Samub432/acoustic-sensor/python/trials/03_baseline_new_hardware/baseline1.csv

pc_timestamp | freq_hz | ampl_adc | arduino_ms | mode | raw_line
1784644223.483011 | 0 | 0 | 0 | META | # BIOREATTORE ACUSTICO v1.0
1784644223.483011 | 0 | 0 | 0 | META | # freq_hz,ampl_adc,timestamp_ms,mode
1784644223.483011 | 0 | 0 | 0 | META | # READY
1784644223.483011 | 0 | 0 | 0 | META | # MODE:SWEEP
1784644223.483011 | 0 | 0 | 0 | META | # SWEEP_START,376
1784644223.5705004 | 999 | 56 | 460 | S | 999,56,460,S
1784644223.6527245 | 1021 | 44 | 544 | S | 1021,44,544,S
1784644223.7385697 | 1042 | 34 | 628 | S | 1042,34,628,S
1784644223.8189645 | 1064 | 25 | 712 | S | 1064,25,712,S
1784644223.900641 | 1087 | 16 | 795 | S | 1087,16,795,S
1784644223.9816594 | 1110 | 15 | 879 | S | 1110,15,879,S
1784644224.062832 | 1133 | 15 | 963 | S | 1133,15,963,S
1784644224.1446793 | 1157 | 15 | 1046 | S | 1157,15,1046,S
1784644224.2422915 | 1181 | 11 | 1130 | S | 1181,11,1130,S
1784644224.3192635 | 1206 | 10 | 1214 | S | 1206,10,1214,S
1784644224.4042242 | 1232 | 17 | 1297 | S | 1232,17,1297,S
1784644224.4849968 | 1258 | 11 | 1380 | S | 1258,11,1380,S
1784644224.5657492 | 1284 | 23 | 1464 | S | 1284,23,1464,S
1784644224.646768 | 1311 | 34 | 1547 | S | 1311,34,1547,S
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
