Samub432/acoustic-sensor/python/trials/03_baseline_new_hardware/baseline2.csv

pc_timestamp | freq_hz | ampl_adc | arduino_ms | mode | raw_line
1784646427.5064514 | 0 | 0 | 0 | META | # BIOREATTORE ACUSTICO v1.0
1784646427.5064514 | 0 | 0 | 0 | META | # freq_hz,ampl_adc,timestamp_ms,mode
1784646427.5064514 | 0 | 0 | 0 | META | # READY
1784646427.5064514 | 0 | 0 | 0 | META | # MODE:SWEEP
1784646427.5064514 | 0 | 0 | 0 | META | # SWEEP_START,377
1784646427.594136 | 999 | 70 | 461 | S | 999,70,461,S
1784646427.6787186 | 1021 | 51 | 545 | S | 1021,51,545,S
1784646427.7622252 | 1042 | 39 | 629 | S | 1042,39,629,S
1784646427.844145 | 1064 | 29 | 713 | S | 1064,29,713,S
1784646427.9252758 | 1087 | 23 | 797 | S | 1087,23,797,S
1784646428.0065086 | 1110 | 21 | 881 | S | 1110,21,881,S
1784646428.0872135 | 1133 | 16 | 964 | S | 1133,16,964,S
1784646428.1713135 | 1157 | 14 | 1048 | S | 1157,14,1048,S
1784646428.2657914 | 1181 | 10 | 1131 | S | 1181,10,1131,S
1784646428.3448424 | 1206 | 11 | 1215 | S | 1206,11,1215,S
1784646428.4296103 | 1232 | 19 | 1298 | S | 1232,19,1298,S
1784646428.5119517 | 1258 | 13 | 1382 | S | 1258,13,1382,S
1784646428.5937316 | 1284 | 9 | 1465 | S | 1284,9,1465,S
1784646428.6794894 | 1311 | 15 | 1548 | S | 1311,15,1548,S
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
