Samub432/acoustic-sensor/python/trials/03_baseline_new_hardware/baseline3.csv

pc_timestamp | freq_hz | ampl_adc | arduino_ms | mode | raw_line
1784647524.6125307 | 0 | 0 | 0 | META | # BIOREATTORE ACUSTICO v1.0
1784647524.6125307 | 0 | 0 | 0 | META | # freq_hz,ampl_adc,timestamp_ms,mode
1784647524.6125307 | 0 | 0 | 0 | META | # READY
1784647524.6125307 | 0 | 0 | 0 | META | # MODE:SWEEP
1784647524.6125307 | 0 | 0 | 0 | META | # SWEEP_START,378
1784647524.6897862 | 999 | 60 | 461 | S | 999,60,461,S
1784647524.7707486 | 1021 | 48 | 545 | S | 1021,48,545,S
1784647524.8682554 | 1042 | 34 | 629 | S | 1042,34,629,S
1784647524.9514194 | 1064 | 28 | 713 | S | 1064,28,713,S
1784647525.0297976 | 1087 | 20 | 797 | S | 1087,20,797,S
1784647525.1105657 | 1110 | 19 | 881 | S | 1110,19,881,S
1784647525.1944249 | 1133 | 14 | 964 | S | 1133,14,964,S
1784647525.272624 | 1157 | 12 | 1048 | S | 1157,12,1048,S
1784647525.3698897 | 1181 | 10 | 1131 | S | 1181,10,1131,S
1784647525.4511354 | 1206 | 13 | 1215 | S | 1206,13,1215,S
1784647525.5229735 | 1232 | 16 | 1298 | S | 1232,16,1298,S
1784647525.6175044 | 1258 | 11 | 1382 | S | 1258,11,1382,S
1784647525.7014065 | 1284 | 21 | 1465 | S | 1284,21,1465,S
1784647525.7872736 | 1311 | 18 | 1549 | S | 1311,18,1549,S
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
