Samub432/acoustic-sensor/holder/Acoustic Sensor - Holder.png

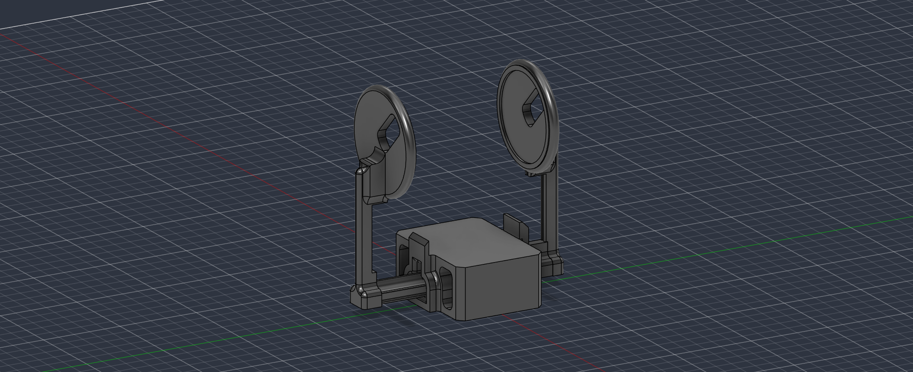
holder/Acoustic Sensor - Holder.png
