Samub432/acoustic-sensor/holder/Acoustic Sensor - Holder.stl

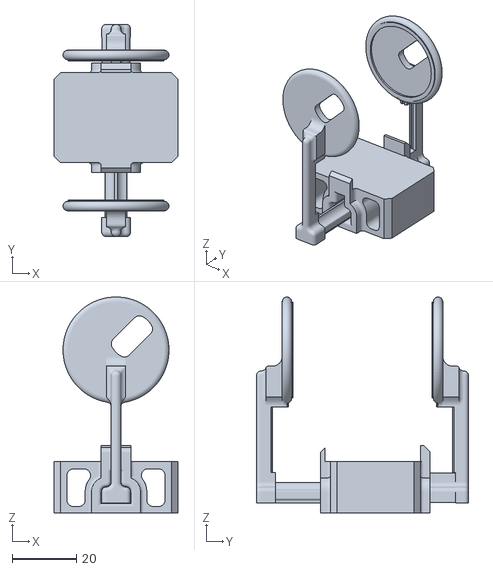
[picture p2: CAD file, 2026-10-16]
holder/Acoustic Sensor - Holder.stl
38.5 x 66.0 x 67.2
