Samub432/acoustic-sensor/(list of files, cad)

Other CAD files:
holder/Acoustic Sensor - Holder.f3d
