Samub432/acoustic-sensor/python/trials/10_Experiment_Nostoc_10052026/Blank 5-10-2026/blank_dark.csv

pc_timestamp | freq_hz | ampl_adc | arduino_ms | mode | raw_line
1791193425.825013 | 0 | 0 | 0 | META | # BIOREATTORE ACUSTICO v1.0
1791193425.825941 | 0 | 0 | 0 | META | # freq_hz,ampl_adc,timestamp_ms,mode
1791193425.826184 | 0 | 0 | 0 | META | # READY
1791193425.826538 | 0 | 0 | 0 | META | # MODE:SWEEP
1791193425.8270059 | 0 | 0 | 0 | META | # SWEEP_START,384
1791193425.827355 | 999 | 81 | 467 | S | 999,81,467,S
1791193425.8277388 | 1021 | 67 | 550 | S | 1021,67,550,S
1791193425.8281002 | 1042 | 63 | 634 | S | 1042,63,634,S
1791193425.828448 | 1064 | 63 | 718 | S | 1064,63,718,S
1791193425.88098 | 1087 | 66 | 802 | S | 1087,66,802,S
1791193425.963468 | 1110 | 58 | 886 | S | 1110,58,886,S
1791193426.0451488 | 1133 | 54 | 969 | S | 1133,54,969,S
1791193426.1312141 | 1157 | 59 | 1053 | S | 1157,59,1053,S
1791193426.2134058 | 1181 | 45 | 1136 | S | 1181,45,1136,S
1791193426.298846 | 1206 | 44 | 1220 | S | 1206,44,1220,S
1791193426.381312 | 1232 | 59 | 1303 | S | 1232,59,1303,S
1791193426.463234 | 1258 | 39 | 1387 | S | 1258,39,1387,S
1791193426.548935 | 1284 | 36 | 1470 | S | 1284,36,1470,S
1791193426.6311722 | 1311 | 20 | 1554 | S | 1311,20,1554,S
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
