Samub432/acoustic-sensor/python/trials/10_Experiment_Nostoc_10052026/Blank 5-10-2026/blank_light.csv

pc_timestamp | freq_hz | ampl_adc | arduino_ms | mode | raw_line
1791194553.3010108 | 0 | 0 | 0 | META | # BIOREATTORE ACUSTICO v1.0
1791194553.301952 | 0 | 0 | 0 | META | # freq_hz,ampl_adc,timestamp_ms,mode
1791194553.302198 | 0 | 0 | 0 | META | # READY
1791194553.3025541 | 0 | 0 | 0 | META | # MODE:SWEEP
1791194553.303026 | 0 | 0 | 0 | META | # SWEEP_START,380
1791194553.362933 | 999 | 84 | 464 | S | 999,84,464,S
1791194553.448599 | 1021 | 79 | 547 | S | 1021,79,547,S
1791194553.531007 | 1042 | 55 | 631 | S | 1042,55,631,S
1791194553.616269 | 1064 | 51 | 715 | S | 1064,51,715,S
1791194553.698892 | 1087 | 46 | 799 | S | 1087,46,799,S
1791194553.780649 | 1110 | 60 | 883 | S | 1110,60,883,S
1791194553.866636 | 1133 | 42 | 966 | S | 1133,42,966,S
1791194553.948766 | 1157 | 38 | 1050 | S | 1157,38,1050,S
1791194554.034396 | 1181 | 51 | 1133 | S | 1181,51,1133,S
1791194554.11669 | 1206 | 42 | 1217 | S | 1206,42,1217,S
1791194554.19859 | 1232 | 44 | 1300 | S | 1232,44,1300,S
1791194554.28439 | 1258 | 35 | 1384 | S | 1258,35,1384,S
1791194554.3665621 | 1284 | 31 | 1467 | S | 1284,31,1467,S
1791194554.448451 | 1311 | 29 | 1551 | S | 1311,29,1551,S
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
