Samub432/acoustic-sensor/python/trials/09_Experiment_Nostoc_09232026/BLANK_23.9.26/blank_001.csv

pc_timestamp | freq_hz | ampl_adc | arduino_ms | mode | raw_line
1790155661.404864 | 0 | 0 | 0 | META | # BIOREATTORE ACUSTICO v1.0
1790155661.405893 | 0 | 0 | 0 | META | # freq_hz,ampl_adc,timestamp_ms,mode
1790155661.4061491 | 0 | 0 | 0 | META | # READY
1790155661.408567 | 0 | 0 | 0 | META | # MODE:SWEEP
1790155661.4091752 | 0 | 0 | 0 | META | # SWEEP_START,385
1790155661.490792 | 999 | 72 | 468 | S | 999,72,468,S
1790155661.576233 | 1021 | 62 | 552 | S | 1021,62,552,S
1790155661.6586292 | 1042 | 59 | 636 | S | 1042,59,636,S
1790155661.740525 | 1064 | 64 | 720 | S | 1064,64,720,S
1790155661.8265479 | 1087 | 58 | 803 | S | 1087,58,803,S
1790155661.9085839 | 1110 | 65 | 887 | S | 1110,65,887,S
1790155661.9944808 | 1133 | 81 | 971 | S | 1133,81,971,S
1790155662.0765781 | 1157 | 84 | 1054 | S | 1157,84,1054,S
1790155662.1619468 | 1181 | 74 | 1138 | S | 1181,74,1138,S
1790155662.244549 | 1206 | 63 | 1222 | S | 1206,63,1222,S
1790155662.326443 | 1232 | 55 | 1305 | S | 1232,55,1305,S
1790155662.412145 | 1258 | 47 | 1388 | S | 1258,47,1388,S
1790155662.494288 | 1284 | 46 | 1472 | S | 1284,46,1472,S
1790155662.576309 | 1311 | 39 | 1555 | S | 1311,39,1555,S
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
