Samub432/acoustic-sensor/python/trials/09_Experiment_Nostoc_09232026/BLANK_23.9.26/blank_002.csv

pc_timestamp | freq_hz | ampl_adc | arduino_ms | mode | raw_line
1790156561.514333 | 0 | 509 | 900654 | P | 0,509,900654,P
1790156561.6167831 | 0 | 504 | 900754 | P | 0,504,900754,P
1790156561.715209 | 0 | 508 | 900854 | P | 0,508,900854,P
1790156561.817483 | 0 | 510 | 900956 | P | 0,510,900956,P
1790156561.915808 | 0 | 513 | 901056 | P | 0,513,901056,P
1790156562.018212 | 0 | 510 | 901156 | P | 0,510,901156,P
1790156562.120091 | 0 | 515 | 901257 | P | 0,515,901257,P
1790156562.218935 | 0 | 504 | 901357 | P | 0,504,901357,P
1790156562.321066 | 0 | 496 | 901458 | P | 0,496,901458,P
1790156562.4196491 | 0 | 503 | 901559 | P | 0,503,901559,P
1790156562.521834 | 0 | 503 | 901659 | P | 0,503,901659,P
1790156562.620394 | 0 | 496 | 901760 | P | 0,496,901760,P
1790156562.7224262 | 0 | 499 | 901861 | P | 0,499,901861,P
1790156562.8210251 | 0 | 496 | 901961 | P | 0,496,901961,P
1790156562.9234529 | 0 | 519 | 902062 | P | 0,519,902062,P
1790156563.0251598 | 0 | 0 | 0 | META | # SWEEP_START,902162
1790156563.107353 | 999 | 152 | 902246 | S | 999,152,902246,S
1790156563.193065 | 1021 | 102 | 902330 | S | 1021,102,902330,S
1790156563.275885 | 1042 | 131 | 902414 | S | 1042,131,902414,S
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
