Samub432/acoustic-sensor/python/trials/09_Experiment_Nostoc_09232026/BLANK_23.9.26/blank_003.csv

pc_timestamp | freq_hz | ampl_adc | arduino_ms | mode | raw_line
1790158285.9810529 | 2305 | 27 | 1657485 | S | 2305,27,1657485,S
1790158285.981953 | 2353 | 22 | 1657568 | S | 2353,22,1657568,S
1790158285.982672 | 2403 | 20 | 1657651 | S | 2403,20,1657651,S
1790158285.983168 | 2454 | 32 | 1657733 | S | 2454,32,1657733,S
1790158285.9836001 | 0 | 513 | 2622540 | P | 0,513,2622540,P
1790158285.9840288 | 0 | 510 | 2622641 | P | 0,510,2622641,P
1790158285.984437 | 0 | 525 | 2622742 | P | 0,525,2622742,P
1790158285.9848452 | 0 | 507 | 2622842 | P | 0,507,2622842,P
1790158285.9852521 | 0 | 511 | 2622943 | P | 0,511,2622943,P
1790158285.9856598 | 0 | 512 | 2623043 | P | 0,512,2623043,P
1790158286.196964 | 0 | 510 | 2623144 | P | 0,510,2623144,P
1790158286.197412 | 0 | 516 | 2623245 | P | 0,516,2623245,P
1790158286.197837 | 0 | 508 | 2623345 | P | 0,508,2623345,P
1790158286.198262 | 0 | 515 | 2623446 | P | 0,515,2623446,P
1790158286.198685 | 0 | 512 | 2623547 | P | 0,512,2623547,P
1790158286.1991072 | 0 | 524 | 2623647 | P | 0,524,2623647,P
1790158286.19953 | 0 | 551 | 2623748 | P | 0,551,2623748,P
1790158286.199952 | 0 | 460 | 2623848 | P | 0,460,2623848,P
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
