Samub432/acoustic-sensor/python/trials/09_Experiment_Nostoc_09232026/BLANK_23.9.26/warmup_blank1.csv

pc_timestamp | freq_hz | ampl_adc | arduino_ms | mode | raw_line
1790154015.994741 | 0 | 0 | 0 | META | # BIOREATTORE ACUSTICO v1.0
1790154015.995727 | 0 | 0 | 0 | META | # freq_hz,ampl_adc,timestamp_ms,mode
1790154015.9959722 | 0 | 0 | 0 | META | # READY
1790154015.996332 | 0 | 0 | 0 | META | # MODE:SWEEP
1790154015.996804 | 0 | 0 | 0 | META | # SWEEP_START,380
1790154016.0316448 | 999 | 88 | 464 | S | 999,88,464,S
1790154016.1180701 | 1021 | 62 | 548 | S | 1021,62,548,S
1790154016.19999 | 1042 | 62 | 631 | S | 1042,62,631,S
1790154016.2860339 | 1064 | 61 | 715 | S | 1064,61,715,S
1790154016.367638 | 1087 | 74 | 799 | S | 1087,74,799,S
1790154016.453394 | 1110 | 86 | 883 | S | 1110,86,883,S
1790154016.53596 | 1133 | 80 | 966 | S | 1133,80,966,S
1790154016.621292 | 1157 | 87 | 1050 | S | 1157,87,1050,S
1790154016.70381 | 1181 | 60 | 1134 | S | 1181,60,1134,S
1790154016.785856 | 1206 | 61 | 1217 | S | 1206,61,1217,S
1790154016.87116 | 1232 | 56 | 1301 | S | 1232,56,1301,S
1790154016.9533372 | 1258 | 58 | 1384 | S | 1258,58,1384,S
1790154017.0356522 | 1284 | 62 | 1467 | S | 1284,62,1467,S
1790154017.121506 | 1311 | 42 | 1551 | S | 1311,42,1551,S
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
