Samub432/acoustic-sensor/python/trials/09_Experiment_Nostoc_09232026/SAMPLE1_23.9.26/sample1_001.csv

pc_timestamp | freq_hz | ampl_adc | arduino_ms | mode | raw_line
1790162665.252115 | 0 | 0 | 0 | META | # BIOREATTORE ACUSTICO v1.0
1790162665.2530618 | 0 | 0 | 0 | META | # freq_hz,ampl_adc,timestamp_ms,mode
1790162665.25331 | 0 | 0 | 0 | META | # READY
1790162665.253669 | 0 | 0 | 0 | META | # MODE:SWEEP
1790162665.254144 | 0 | 0 | 0 | META | # SWEEP_START,384
1790162665.282742 | 999 | 92 | 467 | S | 999,92,467,S
1790162665.364703 | 1021 | 79 | 551 | S | 1021,79,551,S
1790162665.4506829 | 1042 | 78 | 635 | S | 1042,78,635,S
1790162665.532643 | 1064 | 87 | 719 | S | 1064,87,719,S
1790162665.618203 | 1087 | 93 | 802 | S | 1087,93,802,S
1790162665.700426 | 1110 | 105 | 886 | S | 1110,105,886,S
1790162665.786376 | 1133 | 120 | 970 | S | 1133,120,970,S
1790162665.868314 | 1157 | 112 | 1053 | S | 1157,112,1053,S
1790162665.95042 | 1181 | 92 | 1137 | S | 1181,92,1137,S
1790162666.036501 | 1206 | 80 | 1221 | S | 1206,80,1221,S
1790162666.118405 | 1232 | 59 | 1304 | S | 1232,59,1304,S
1790162666.204043 | 1258 | 51 | 1388 | S | 1258,51,1388,S
1790162666.2863328 | 1284 | 38 | 1471 | S | 1284,38,1471,S
1790162666.368274 | 1311 | 29 | 1554 | S | 1311,29,1554,S
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
