Samub432/acoustic-sensor/python/trials/09_Experiment_Nostoc_09232026/SAMPLE1_23.9.26/sample1_002.csv

pc_timestamp | freq_hz | ampl_adc | arduino_ms | mode | raw_line
1790163711.544493 | 3153 | 62 | 656284 | S | 3153,62,656284,S
1790163711.544936 | 3219 | 89 | 656367 | S | 3219,89,656367,S
1790163711.5453708 | 3287 | 62 | 656449 | S | 3287,62,656449,S
1790163711.5458078 | 3356 | 26 | 656532 | S | 3356,26,656532,S
1790163711.546239 | 3427 | 65 | 656615 | S | 3427,65,656615,S
1790163711.54674 | 1486 | 29 | 1044131 | S | 1486,29,1044131,S
1790163711.547177 | 1518 | 66 | 1044214 | S | 1518,66,1044214,S
1790163711.5476139 | 1550 | 61 | 1044298 | S | 1550,61,1044298,S
1790163711.548049 | 1583 | 17 | 1044381 | S | 1583,17,1044381,S
1790163711.548485 | 1616 | 71 | 1044464 | S | 1616,71,1044464,S
1790163711.548921 | 1650 | 67 | 1044547 | S | 1650,67,1044547,S
1790163711.549357 | 1685 | 47 | 1044630 | S | 1685,47,1044630,S
1790163711.549792 | 1720 | 59 | 1044713 | S | 1720,59,1044713,S
1790163711.5502279 | 1757 | 64 | 1044796 | S | 1757,64,1044796,S
1790163711.550689 | 1794 | 126 | 1044879 | S | 1794,126,1044879,S
1790163711.5511522 | 1832 | 44 | 1044961 | S | 1832,44,1044961,S
1790163711.5515919 | 1870 | 72 | 1045044 | S | 1870,72,1045044,S
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
