Samub432/acoustic-sensor/(commit log)

2026-10-06 Relocating all the files to a new repository for better organization and management.
    [alternate_4.csv, baseline1.csv, baseline2.csv, baseline3.csv, baseline_E_2.csv, baseline_E_nothing - Copia.csv, baseline_E_nothing.csv, baseline_for_sparkling.csv]
2026-10-06 Fixed readme file and added a new function to the sensor data script.
    [01_data_from_sensor.py]
2026-10-10 Fixed the issue with the Acoustic Sensor code and updated the README files to reflect the changes made.
    [Acoustic_Sensor.ino]
2026-10-14 Added the past trials data for the Nostoc experiments
    [Blank_dark.csv, alternate_4.csv, baseline1.csv, baseline2.csv, baseline3.csv, baseline_E_2.csv, baseline_E_nothing - Copia.csv, baseline_E_nothing.csv]
2026-10-14 Fixed small things in Arduino files
    [Acoustic_Sensor.ino]
2026-10-14 Fixed the readme files
    [Acoustic_Sensor.ino]
2026-10-14 Removed copy of the data
    [baseline_E_nothing - Copia.csv, bubbles_light1_ok - Copia.csv, bubbles_light2_ok - Copia.csv, dark1 - Copia.csv, dark2 - Copia.csv, dark3 - Copia.csv, light1 - Copia.csv, light2 - Copia.csv]
2026-10-14 Fixed small bug in file 01, there was a wrong variable name in the function that reads the data from the sensor.
    [01_data_from_sensor.py, 02_analysis.py, 03_features.py, acoustic_common.py, test_common.py, test_split.py]
2026-10-14 Fixed small typo in the code of 04
    [04_realtime_monitor.py]
2026-10-14 Added license, correct some bugs in 01 and 02, fixed readme
    [01_data_from_sensor.py, 02_analysis.py, 03_features.py, 04_realtime_monitor.py, Acoustic_Sensor.ino, acoustic_common.py, test_TX_TR.ino, test_common.py]
2026-10-14 Fix to the license, added docs, and added copyright headers to all files.
    [01_data_from_sensor.py, 02_analysis.py, 03_features.py, 04_realtime_monitor.py, Acoustic_Sensor.ino, acoustic_common.py, test_TX_TR.ino, test_common.py]
2026-10-16 Added the trial data
    [Blank_dark.csv, blank_001.csv, blank_002.csv, blank_003.csv, blank_dark.csv, blank_light.csv, sample1_001.csv, sample1_002.csv]
2026-10-16 Added new holder design for the Acoustic Sensor and updated documentation to version 2.
    [Acoustic Sensor - Holder.f3d]
2026-10-16 Added the missing holder file
    [Acoustic Sensor - Holder.stl]
2026-10-17 New experiment addes
    [blank_dark3.csv, blank_light3.csv, blank_lucelab.csv, sample_dark1.csv, sample_dark2.csv, sample_light1.csv, sample_light2.csv]
2026-10-20 Major fix to the code
    [03_features.py, acoustic_common.py, test_common.py]
2026-10-20 Small fix to the code
    [01_data_from_sensor.py, 02_analysis.py, 03_features.py, 04_realtime_monitor.py, Acoustic_Sensor.ino, acoustic_common.py, test_TX_TR.ino, test_pin.ino]
